remiserriere/FordCougarEnhancedCluster/pictures/pic02.jpg

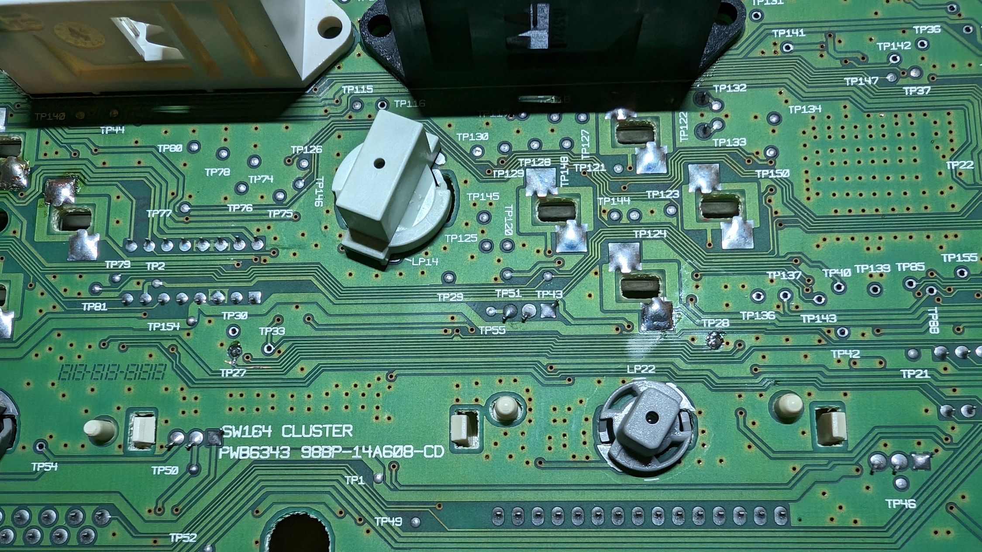
pictures/pic02.jpg
