remiserriere/FordCougarEnhancedCluster/pictures/pic05_raw.jpg

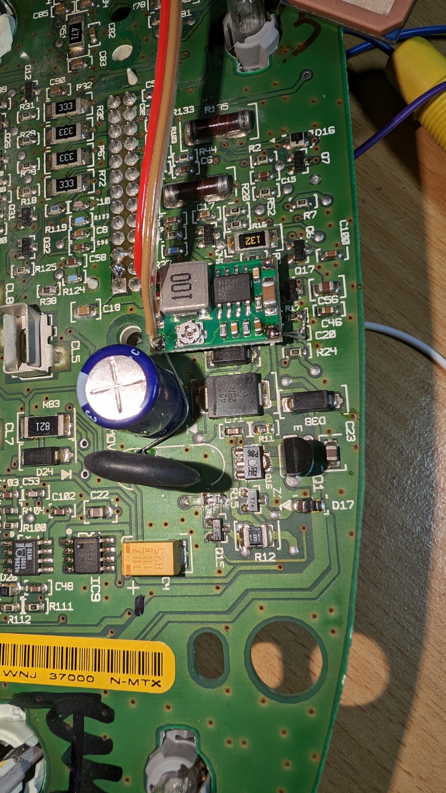
pictures/pic05_raw.jpg
