remiserriere/FordCougarEnhancedCluster/(commit log)

2023-12-15 Added chip datasheet, board pinout, picture of lcd segments, excel decoding Code: added GPS support, fixed flickering with I2C inbound, data displayed only in speed mode, automatic selection of speed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
    [Ford Cougar Cluster - LCD I2C decoding.xlsx]
2023-12-17 Code cleanup Missing: i2c onReceive: speedMode: trigger even if all pixels are on (cluster startup, debug, etc...)
    [GPS.ino]
2023-12-17 Cleaning up
    [Ford Cougar Cluster - LCD I2C decoding.xlsx]
2023-12-17 Fixed cluster boot/debug where all pixels of LCD 1 would trigger speed mode
    [FordCougarEnhancedCluster.ino]
2023-12-18 Added GPS time display
    [Ford Cougar Cluster - LCD I2C decoding.xlsx]
2023-12-29 major readme update
    [Ford Cougar Cluster - LCD I2C decoding.xlsx]
